ceruleansubmergence/OmniJoy/README.md

# OmniJoy
A repository for all things OmniJoy
