ceruleansubmergence/OmniJoy/Hardware/README.md

# OmniJoy
A repository for hardware items

There are lots of booboos on the Rev 0 schematic.  Don't build one unless you find them first!
