ceruleansubmergence/OmniJoy/(list of files, cad)

Other CAD files:
Software/RGB666/ER-TFT035-6(4-Wire-SPI)_TP_SD__DemoCode/sd.OBJ
