ceruleansubmergence/OmniJoy/Firmware/Testing_Firmware_CPPM/jm_CPPM/examples/Monitor/DX5e.xls

Index | 0 | 1 | 2 | 3 | 4 | 5 | 6 | 7 | 8 | 9 | 10
CPPM | AILE | ELEV | THRO | RUDD | GEAR | AUX1 | AUX2 | AUX3 | AUX4 | GAP | FRAME
DX5e | THR | AIL | ELE | RUD | CH5 | AUX | GAP | FRAME
Sync | 378 | 378 | 378 | 378 | 377 | 378 | 378 | 0 | 0 | 0 | 0
Pulse | 1101 | 1498 | 1499 | 1504 | 1101 | 1100 | 14202 | 22006 | 0 | 0 | 0
