ceruleansubmergence/OmniJoy/Firmware/Testing_Firmware_CPPM/jm_CPPM/examples/ServoMeter/ServoMeter_AR615X_DSM2.xls

DX8 | AX1 | [0.5us] | [us] | 100% | 125% | 150%
 | Flap=0 | 3827 | 1913.5 | 414.5 | 518.125 | 621.75
 | Flap=1 | 2998 | 1499
 | Flap=2 | 2169 | 1084.5 | 414.5 | 518.125 | 621.75
 | Flap=0-0% | 2996 | 1498 | -1 | -0.2412545235
 | Flap=0-25% | 3203 | 1601.5 | 102.5 | 24.72858866
 | Flap=0-50% | 3410 | 1705 | 206 | 49.69843185
 | Flap=0-75% | 3616 | 1808 | 309 | 74.54764777
 | Flap=0-100% | 3825 | 1912.5 | 413.5 | 99.75874548
 | Flap=0-125% | 4032 | 2016 | 517 | 124.7285887
 | Flap=0-150% | 4238 | 2119 | 620 | 149.5778046
 | frame | 43960 | 21980
 | stick center | 2998 | 1499
AR615X | frame | 45540 | 22770
 |  | 45520 | 22760
