ceruleansubmergence/OmniJoy/Firmware/Testing_Firmware_CPPM/jm_CPPM/examples/ServoMeter/ServoMeter_R615X_DSMX.xls

DX8 | AX1 | [0.5us] | [us] | [+/-us] | 100% | 125% | 150% | 175% | 200%
100% | Flap=0 | 3817 | 1908.5 | 413 | 1908.5 | 2011.75 | 2115 | 2218.25 | 2321.5
0% | Flap=1 | 2991 | 1495.5
-100% | Flap=2 | 2165 | 1082.5 | -413 | 1082.5 | 979.25 | 876 | 772.75 | 669.5
 |  |  |  | [+/-us] | 413 | 516.25 | 619.5 | 722.75 | 826
 | frame sync | 43960 | 21980
 |  | 43943 | 21971.5
 |  | 43978 | 21989
 | stick center | 2991 | 1495.5
R615X | frame unsync | 45433 | 22716.5
DSMX |  | 45462 | 22731
 | pulse center |  | 1504
