ceruleansubmergence/OmniJoy/Firmware/Testing_Firmware_CPPM/jm_CPPM/examples/ServoMeter/ServoMeter_R920X_DSMX.xls

DX8 | AX1 | [0.5us] | [us] | [+/-us] | 100% | 125% | 150% | 175% | 200%
100% | Flap=0 | 3918 | 1959 | 454.5 | 1959 | 2072.625 | 2186.25 | 2299.875 | 2413.5
0% | Flap=1 | 3009 | 1504.5
-100% | Flap=2 | 2100 | 1050 | -454.5 | 1050 | 936.375 | 822.75 | 709.125 | 595.5
 |  |  |  | [+/-us] | 454.5 | 568.125 | 681.75 | 795.375 | 909
 | frame sync | 43960 | 21980
 |  | 43943 | 21971.5
 |  | 43978 | 21989
 | stick center | 3009 | 1504.5
R920X | frame unsync | 44242 | 22121
DSMX |  | 44250 | 22125
 | pulse center |  | 1509
