ceruleansubmergence/OmniJoy/Firmware/Testing_Firmware_CPPM/jm_CPPM/2015-08-05/NewFile1.bmp

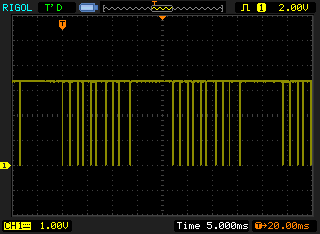
Firmware/Testing_Firmware_CPPM/jm_CPPM/2015-08-05/NewFile1.bmp
